ArendJan/easyIoT/README.md

# EasyIoT
Follow [the tutorial](./tutorial.md) for how to install and use.
