ArendJan/easyIoT/schema/airQualityV2/schema.png

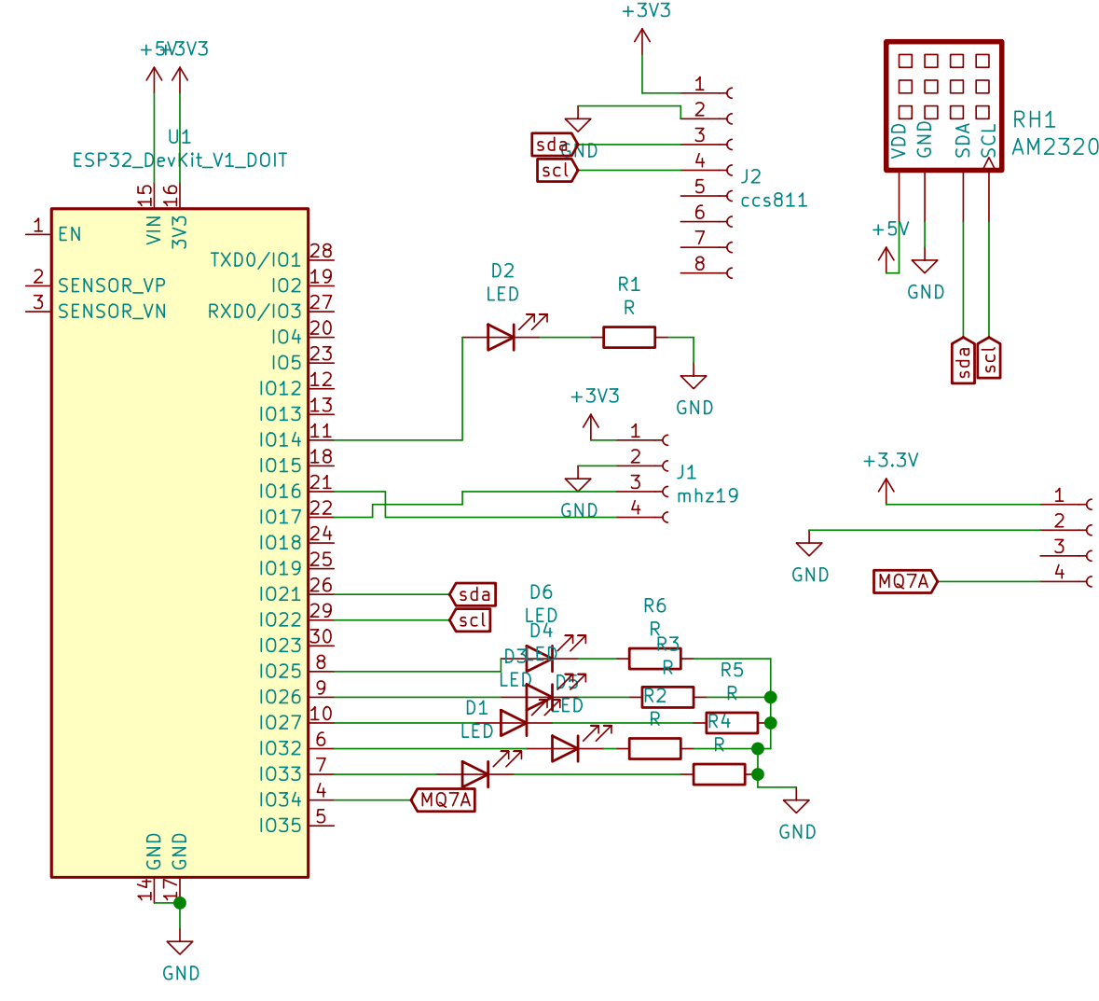
schema/airQualityV2/schema.png
