ArendJan/easyIoT/schema/airQualityV2/render.FCStd

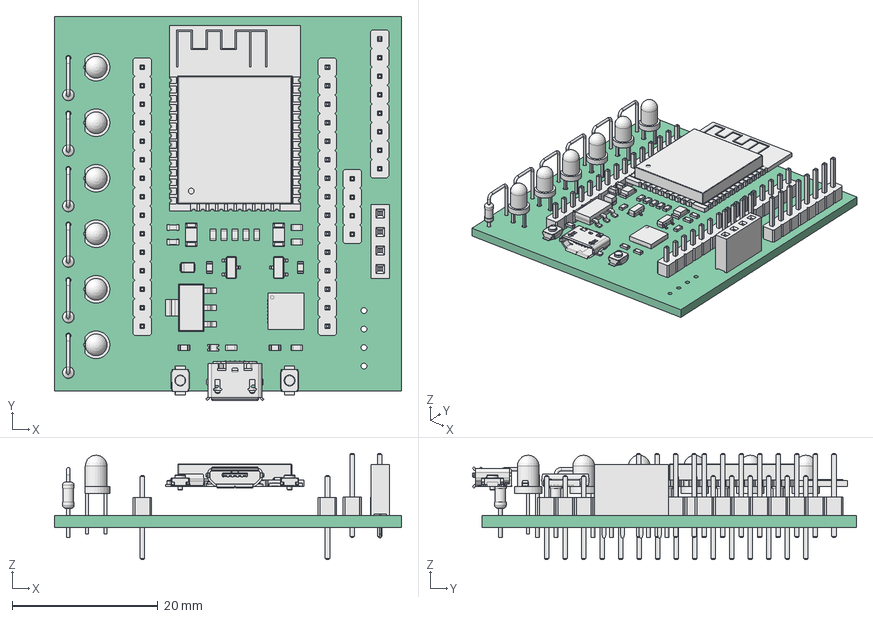
[picture p23: CAD file, 2021-11-17]
schema/airQualityV2/render.FCStd
47.6 x 52.8 x 14.6 mm
Pcb_a875
J3_PinSocket_1x04_P254mm_Vertical_61802A0E
R6_R_Axial_DIN0204_L36mm_D16mm_P508mm_Vertical_617A41DC
D6_LED_D3.0mm_617A40DD
R5_R_Axial_DIN0204_L36mm_D16mm_P508mm_Vertical_617A3931
R4_R_Axial_DIN0204_L36mm_D16mm_P508mm_Vertical_617A3922
R3_R_Axial_DIN0204_L36mm_D16mm_P508mm_Vertical_617A3913
R2_R_Axial_DIN0204_L36mm_D16mm_P508mm_Vertical_617A3904
R1_R_Axial_DIN0204_L36mm_D16mm_P508mm_Vertical_617A38F5
D5_LED_D3.0mm_617A3882
D4_LED_D3.0mm_617A386F
D3_LED_D3.0mm_617A385C
D2_LED_D3.0mm_617A3849
D1_LED_D3.0mm_617A3836
U1_SW_SPST_B3U-1000P-B_617A342D
U1_SW_SPST_B3U-1000P-B_617A342D[2]
U1_PinHeader_1x15_P254mm_Vertical_617A342D[3]
U1_PinHeader_1x15_P254mm_Vertical_617A342D[4]
U1_USB_Micro-B_Molex_47346-0001_617A342D[6]
U1_LED_1206_3216Metric_617A342D[7]
U1_LED_1206_3216Metric_617A342D[8]
U1_CP_EIA_2012_15_AVX_P_617A342D[9]
U1_SOT_223_617A342D[10]
U1_R_0603_1608Metric_617A342D[11]
U1_R_0603_1608Metric_617A342D[12]
U1_R_0603_1608Metric_617A342D[13]
U1_SOT_23_617A342D[14]
U1_SOT_23_617A342D[15]
U1_R_0603_1608Metric_617A342D[16]
U1_R_0603_1608Metric_617A342D[17]
U1_C_0603_1608Metric_617A342D[18]
U1_D_0603_617A342D[19]
U1_R_0603_1608Metric_617A342D[20]
U1_R_0603_1608Metric_617A342D[21]
U1_R_0603_1608Metric_617A342D[22]
U1_R_0603_1608Metric_617A342D[23]
U1_R_0603_1608Metric_617A342D[24]
U1_QFN-28-1EP_5x5mm_Pitch0.5mm_617A342D[25]
U1_R_0603_1608Metric_617A342D[26]
U1_R_0603_1608Metric_617A342D[27]
U1_C_0603_1608Metric_617A342D[28]
U1_C_0603_1608Metric_617A342D[29]
U1_ESP32-WROOM-32_617A342D[30]
J2_PinHeader_1x08_P254mm_Vertical_6179D22C
J1_PinHeader_1x04_P254mm_Vertical_61802BDC
