ArendJan/easyIoT/schema/airQualityV2/airQualityV2.pdf

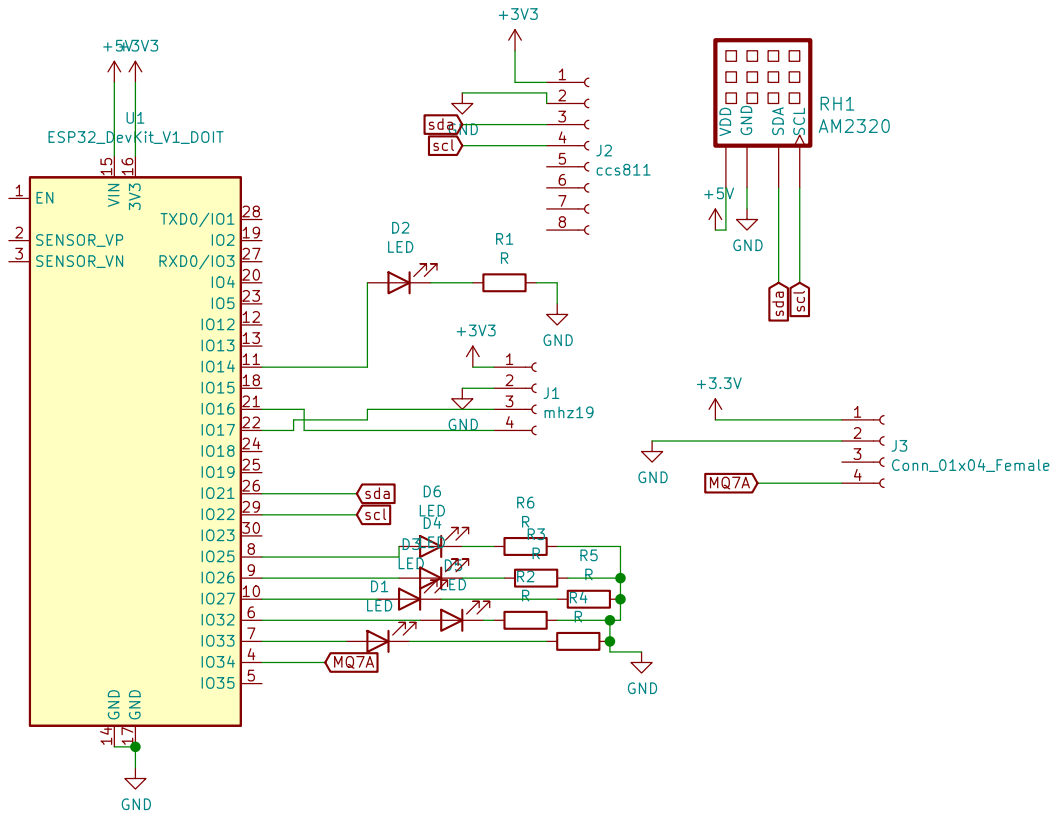
[picture p24: page 1]
