ArendJan/easyIoT/(list of files, drawings)

Other design files:
schema/airQualityV2/airQualityV2.dsn
