ArendJan/easyIoT/schema/airQualityV2/airQualityV2.kicad_pcb

## KiCad design schema/airQualityV2/airQualityV2.kicad_pcb (2021-11-23)

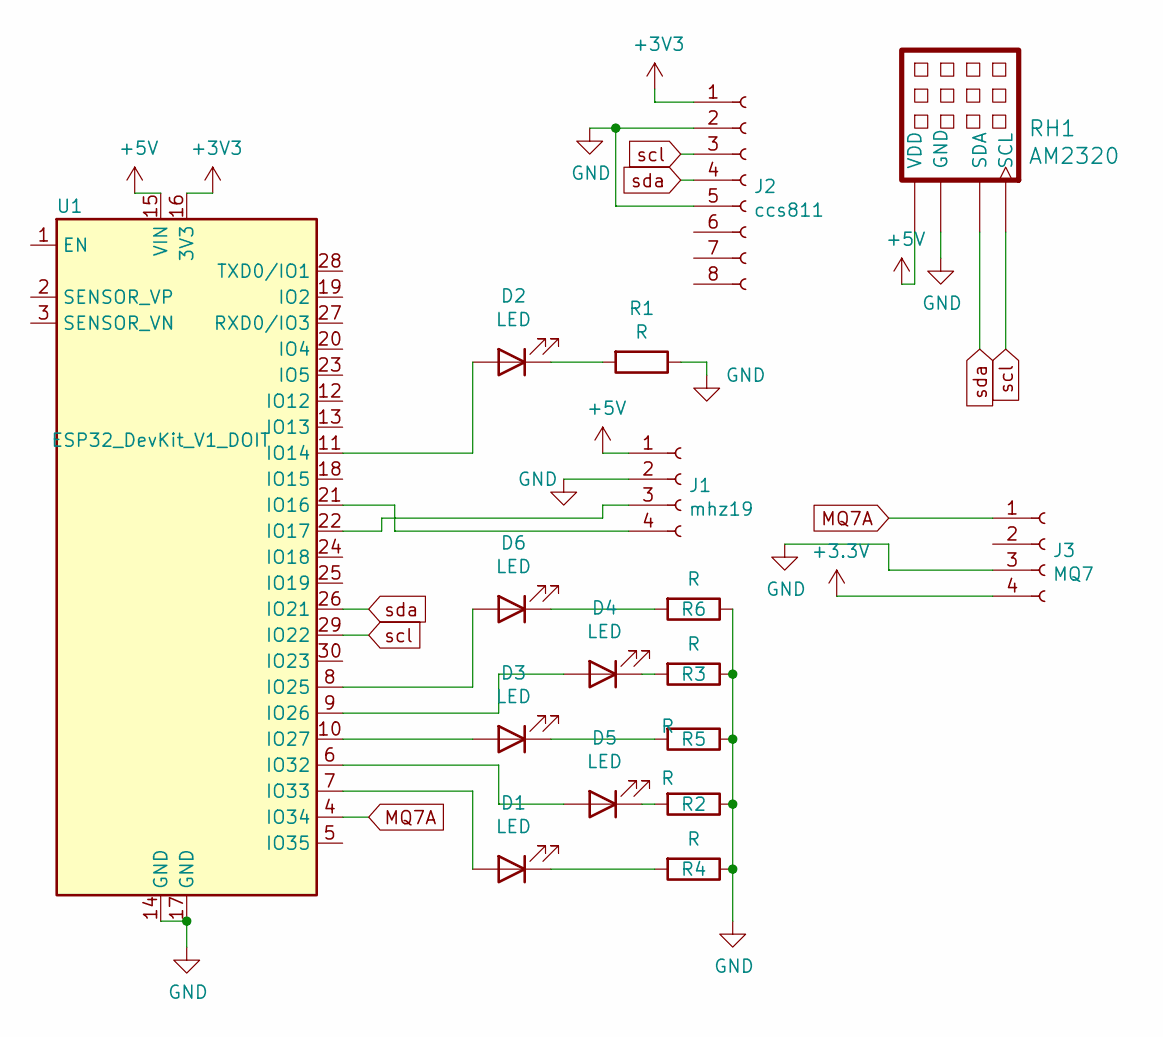
[picture p25: schematic airQualityV2.sch]

Parts:
D1, D2, D3, D4, D5, D6: LED; LED_D3.0mm
J1: mhz19; PinHeader_1x04_P2.54mm_Vertical
J2: ccs811; PinHeader_1x08_P2.54mm_Vertical
J3: MQ7; PinSocket_1x04_P2.54mm_Vertical
R1, R2, R3, R4, R5, R6: R; R_Axial_DIN0204_L3.6mm_D1.6mm_P5.08mm_Vertical
RH1: AM2320
U1: ESP32_DevKit_V1_DOIT; esp32_devkit_v1_doit

Connections:
+5V: J1.1, RH1.1 (VDD), U1.15 (VIN)
GND: J1.2, J2.2, J2.5, J3.3, R1.1, R2.1, R3.1, R4.1, R5.1, R6.1, RH1.3 (GND), U1.14 (GND), U1.17 (GND)
MQ7A: J3.1, U1.4 (IO34)
unnamed: D1.1 (K), R4.2
unnamed: D1.2 (A), U1.7 (IO33)
unnamed: D2.1 (K), R1.2
unnamed: D2.2 (A), U1.11 (IO14)
unnamed: D3.1 (K), R5.2
unnamed: D3.2 (A), U1.10 (IO27)
unnamed: D4.1 (K), R3.2
unnamed: D4.2 (A), U1.9 (IO26)
unnamed: D5.1 (K), R2.2
unnamed: D5.2 (A), U1.6 (IO32)
unnamed: D6.1 (K), R6.2
unnamed: D6.2 (A), U1.8 (IO25)
unnamed: J1.3, U1.22 (IO17)
unnamed: J1.4, U1.21 (IO16)
scl: J2.3, RH1.4 (SCL), U1.29 (IO22)
sda: J2.4, RH1.2 (SDA), U1.26 (IO21)

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
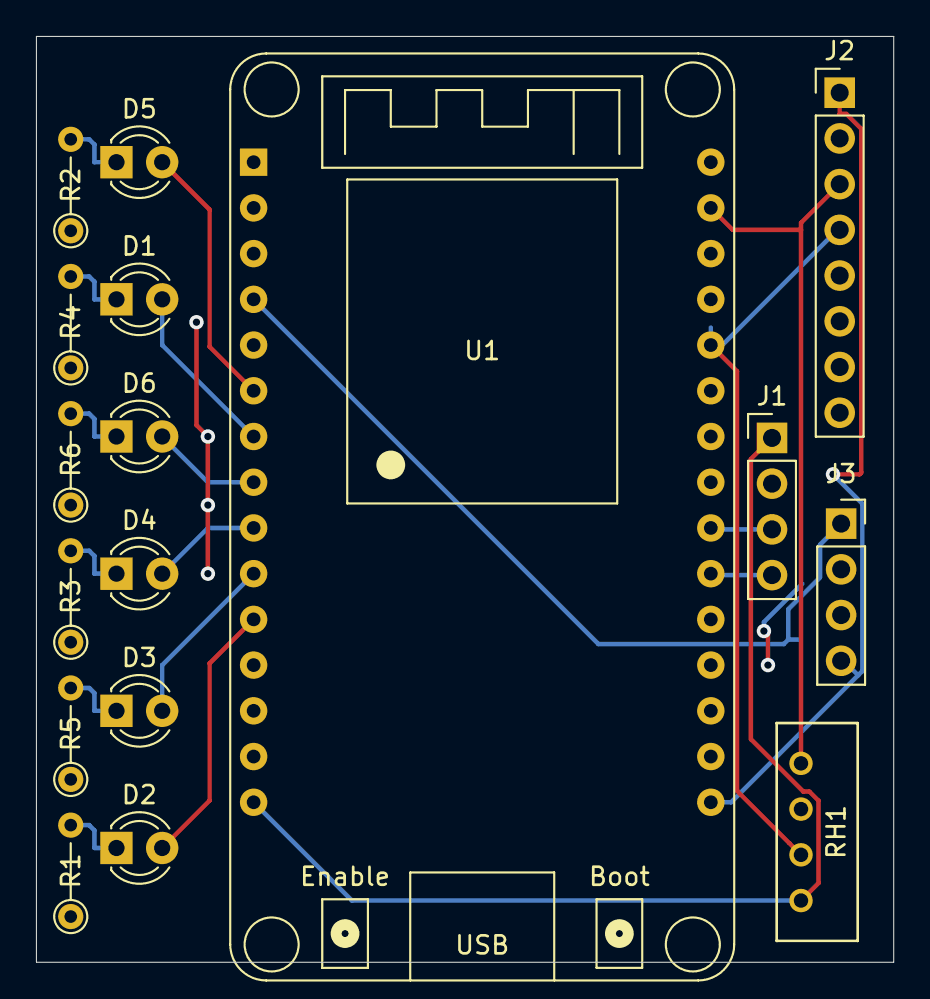
[picture p26: board airQualityV2.kicad_pcb from above]

Board: 2 copper layers, 47.6 x 51.4 mm, 17 parts (0 on the bottom side), 20 nets.
