ArendJan/easyIoT/esp/src/mq7sensor.cpp

#include <MQUnifiedsensor.h>
#include "sensorFramework.hpp"
// MQ-7 wiring
#define Board ("ESP-32") // Wemos ESP-32 or other board, whatever have ESP32 core.
#define PinMQ7 (34)      //IO25 for your ESP32 WeMos Board, pinout here: https://i.pinimg.com/originals/66/9a/61/669a618d9435c702f4b67e12c40a11b8.jpg
/***********************Software Related Macros************************************/
#define Type ("MQ-7")            //MQ3 or other MQ Sensor, if change this verify your a and b values.
#define Voltage_Resolution (3.3) // 3V3 <- IMPORTANT. Source: https://randomnerdtutorials.com/esp32-adc-analog-read-arduino-ide/
#define ADC_Bit_Resolution (12)  // ESP-32 bit resolution. Source: https://randomnerdtutorials.com/esp32-adc-analog-read-arduino-ide/
#define RatioMQ7CleanAir (27.5)  // Ratio of your sensor, for this example an MQ-3

MQUnifiedsensor MQ7(Board, Voltage_Resolution, ADC_Bit_Resolution, PinMQ7, Type);

void initMQ7()
{
  //Set math model to calculate the PPM concentration and the value of constants
  MQ7.setRegressionMethod(1); //_PPM =  a*ratio^b
  MQ7.setA(99.042);
  MQ7.setB(-1.518); // Configurate the ecuation values to get CO concentration

  /*
    Exponential regression:
  GAS     | a      | b
  H2      | 69.014  | -1.374
  LPG     | 700000000 | -7.703
  CH4     | 60000000000000 | -10.54
  CO      | 99.042 | -1.518
  Alcohol | 40000000000000000 | -12.35
  */

  /*****************************  MQ Init ********************************************/
  //Remarks: Configure the pin of arduino as input.
  /************************************************************************************/
  MQ7.init();
  /* 
    //If the RL value is different from 10K please assign your RL value with the following method:
    MQ7.setRL(10);
  */
  /*****************************  MQ CAlibration ********************************************/
  // Explanation:
  // In this routine the sensor will measure the resistance of the sensor supposing before was pre-heated
  // and now is on clean air (Calibration conditions), and it will setup R0 value.
  // We recomend execute this routine only on setup or on the laboratory and save on the eeprom of your arduino
  // This routine not need to execute to every restart, you can load your R0 if you know the value
  // Acknowledgements: https://jayconsystems.com/blog/understanding-a-gas-sensor
  Serial.print("Calibrating please wait.");
  float calcR0 = 0;
  for (int i = 1; i <= 10; i++)
  {
    MQ7.update(); // Update data, the arduino will be read the voltage on the analog pin
    calcR0 += MQ7.calibrate(RatioMQ7CleanAir);
    Serial.print(".");
  }
  MQ7.setR0(calcR0 / 10);
  Serial.println("  done!.");

  if (isinf(calcR0))
  {
    Serial.println("Warning: Conection issue founded, R0 is infite (Open circuit detected) please check your wiring and supply");
    while (1)
      ;
  }
  if (calcR0 == 0)
  {
    Serial.println("Warning: Conection issue founded, R0 is zero (Analog pin with short circuit to ground) please check your wiring and supply");
    while (1)
      ;
  }
  /*****************************  MQ CAlibration ********************************************/
  MQ7.serialDebug(true);
}

int dataMQ7(DynamicJsonDocument &doc)
{
  MQ7.update(); // Update data, the arduino will be read the voltage on the analog pin
  doc["mq7_ppm"] = MQ7.readSensor();
  doc["mq7_volt"] = MQ7.getVoltage();
  float PPM = 0;

  PPM = MQ7.readSensor(); // Sensor will read PPM concentration using the model and a and b values setted before or in the setup
  MQ7.serialDebug();      // Will print the table on the serial port
}
