ArendJan/easyIoT/(commit log)

2021-11-17 easyIoT copy code without passwords!
    [airQualityV2-B_Cu.gbr, airQualityV2-B_Mask.gbr, airQualityV2-B_Paste.gbr, airQualityV2-B_SilkS.gbr, airQualityV2-Edge_Cuts.gbr, airQualityV2-F_Cu.gbr, airQualityV2-F_Mask.gbr, airQualityV2-F_Paste.gbr]
2021-11-23 update schematic
    [airQualityV2.kicad_pcb, airQualityV2.sch]
